WitsOCLab/Two-Inch-Photodetector/OPA818_TwoInch/BOM_OIP_OPA818.ods

One-Inch-Photodetector, OPA818
https://github.com/aewallin/One-Inch-Photodetector
REF | Description | part | footprint | QTY | price, EUR | total, EUR | Digikey/Farnell
 | MMCX-SMA lead |  |  | 1 | 9.55 | 9.55 | 744-1700-ND
D101,D103 | diode |  | SOD323F | 2 |  | 0
D102 | Photodiode |  | TO-18 | 1 |  | 0
J101 | MMCX conn | MMCX_Molex_73415-1471 |  | 1 | 2.39 | 2.39 | WM5557-ND
U104 | buffer | BUF602 | SOT23-5 | 1 | 2.1 | 2.1 | 296-19310-1-ND
U103 | opamp | OPA818IDRG | Wson-8 3x3 | 1 | 6.24 | 6.24 | 296-OPA818IDRGRCT-ND
U102 | vreg neg | LT3093 | MSOP-12 | 1 | 4.74 | 4.74 | LT3093EMSE#PBF-ND
U101 | vreg pos | LT3042 | MSOP-10 | 1 | 4.5 | 4.5 | LT3042EMSE#PBF-ND
 | Power supply | ±12 VDC 6 W, 100/120/230 VAC |  | 1 | 77.46 | 77.46 | Thorlabs LDS12B
 | M8 conn, lead | CBL FMALE TO WIRE LEAD 3P 4.92' |  | 1 | 6.91 | 6.91 | A120947-ND
 | Lumberg connector for power-supply | 3-pin female |  |  | SUM | 113.89
 |  |  |  |  |  |  |  | LUMBERG RSMV3 Male Connector
