WitsOCLab/Two-Inch-Photodetector/OPA818_TwoInch/oip_opa818.csv

Id | Designator | Footprint | Quantity | Designation | Supplier and ref
1 | D102 | TO-18-3 | 1 | S597x
2 | U101 | MSOP-10-1EP_3x3mm_P0.5mm_EP1.68x1.88mm | 1 | LT3042xMSE
3 | U102 | MSOP-12-1EP_3x4mm_P0.65mm_EP1.65x2.85mm | 1 | LT3093xMSE
4 | C101,C102,C103,C107,C112,C113,C114 | C_0603_1608Metric | 7 | 4u7
5 | C108,C105,C106,C109 | C_0603_1608Metric | 4 | 100n
6 | D103,D101 | D_SOD-323F | 2 | D
7 | J101,J1 | MMCX_Molex_73415-1471_Vertical | 2 | Conn_Coaxial
8 | L101 | L_0805_2012Metric | 1 | 100u
9 | R101,R107 | R_0603_1608Metric | 2 | 51k
10 | R102 | R_0603_1608Metric | 1 | 300R
11 | RF101 | R_0402_1005Metric | 1 | R
12 | R106 | R_0402_1005Metric | 1 | 49R9
13 | C115 | C_0402_1005Metric | 1 | C
14 | R1 | R_0402_1005Metric | 1 | 10R
15 | U103 | WSON-8-1EP_3x3mm_P0.5mm_EP1.45x2.4mm | 1 | OPA818IDRGx
16 | U104 | SOT-23-5 | 1 | BUF602xDBV
17 | C104 | C_0603_1608Metric | 1 | 10n
18 | R4 | R_0402_1005Metric | 1 | 100
19 | R3 | R_0402_1005Metric | 1 | 1.28k
20 | C6,C7 | NFM21C | 2 | NFM21PC105B1C3D
21 | C3 | C_0402_1005Metric | 1 | 10n
22 | R5 | R_0402_1005Metric | 1 | 49.9R
23 | RF1 | R_0402_1005Metric | 1 | 0R
24 | R2 | R_0402_1005Metric | 1 | 21.2k
25 | C5,C1 | C_0402_1005Metric | 2 | 100n
26 | C4 | C_0402_1005Metric | 1 | 1n
27 | U1 | MSOP-8_3x3mm_P0.65mm | 1 | AD8656
28 | R6 | R_0402_1005Metric | 1 | 470
29 | D1,D2 | LED_0201_0603Metric | 2 | LED
30 | TP101,TP102 | TestPoint_THTPad_D1.0mm_Drill0.5mm | 2 | TestPoint
31 | J102 | PinHeader_1x03_P2.54mm_Vertical | 1 | Conn_01x03
