WitsOCLab/Two-Inch-Photodetector/OPA818_TwoInch/oip_opa818.kicad_pcb

## KiCad design OPA818_TwoInch/oip_opa818.kicad_pcb (2025-04-06)

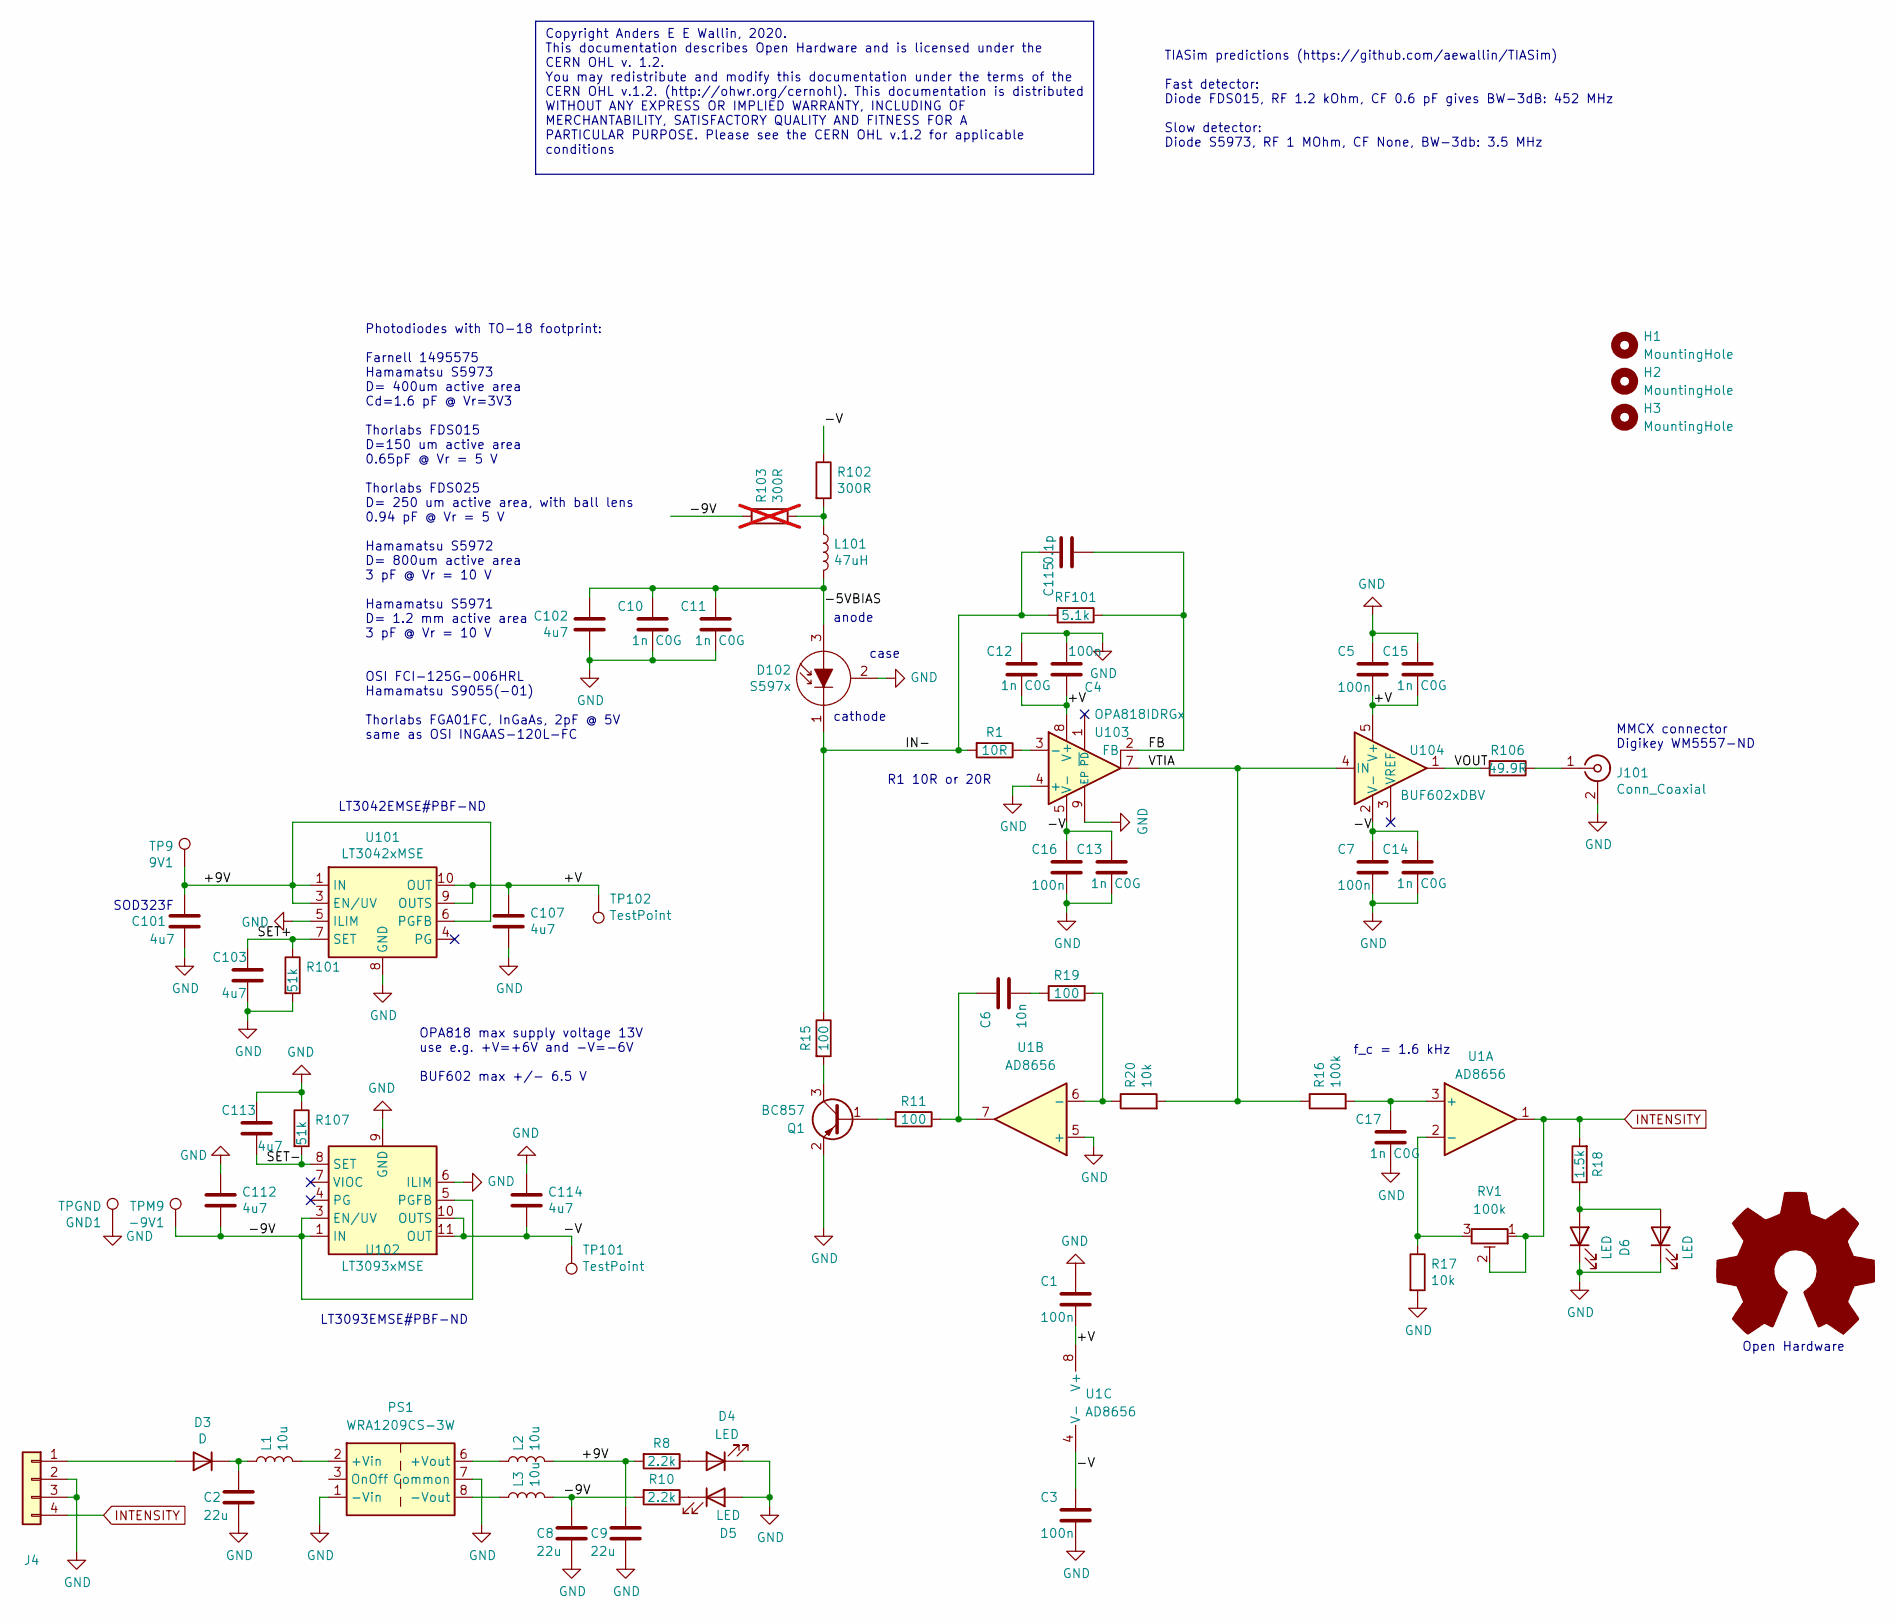
[picture p1: schematic oip_opa818.kicad_sch, 1" Photodiode Transimpedance Amplifier - OPA818 + BUF602]

Parts:
9V1: TP9; TestPoint_THTPad_D1.0mm_Drill0.5mm
-9V1: TPM9; TestPoint_THTPad_D1.0mm_Drill0.5mm
C1, C3, C4, C5, C7, C16: 100n; C_0402_1005Metric; JLCPCB C307331
C2, C8, C9: 22u; C_0805_2012Metric; JLCPCB C45783
C6: 10n; C_0402_1005Metric; LCSC C15195
C10, C11, C12, C13, C14, C15, C17: 1n C0G; C_0402_1005Metric; JLCPCB C76947
C101, C102, C103, C107, C112, C113, C114: 4u7; C_0603_1608Metric; JLCPCB C19666
C115: 0.1p; C_0402_1005Metric; LCSC C53273
D3: D; D_SOD-323F; JLCPCB C191023
D4, D5, D6, D7: LED; LED_0603_1608Metric; JLCPCB C72043
D102: S597x; TO-18-3
GND1: TPGND; TestPoint_THTPad_D1.0mm_Drill0.5mm
H1, H2, H3: MountingHole; MountingHole_3.2mm_M3_DIN965_Pad_TopBottom
J4: PinHeader_1x04_P2.54mm_Vertical
J101: Conn_Coaxial; MMCX_Molex_73415-1471_Vertical; JLCPCB C530664
L1, L2, L3: 10u; L_0805_2012Metric; JLCPCB C281113
L101: 47uH; L_0805_2012Metric; LCSC C404762
PS1: WRA1209CS-3W; Converter_DCDC_XP_POWER-ITQxxxxS-H_THT; LCSC C512079
Q1: BC857; SOT-323_SC-70; LCSC C8660
R1: 10R; R_0402_1005Metric; JLCPCB C25077
R8, R10: 2.2k; R_0402_1005Metric; JLCPCB C25879
R11, R15, R19: 100; R_0402_1005Metric; JLCPCB C25076
R16: 100k; R_0402_1005Metric; LCSC C25741
R17, R20: 10k; R_0402_1005Metric; LCSC C25744
R18: 1.5k; R_0603_1608Metric; LCSC C22843
R101, R107: 51k; R_0603_1608Metric; JLCPCB C23186
R102: 300R; R_0603_1608Metric; JLCPCB C23025
R103: 300R; R_0603_1608Metric; JLCPCB C23025; not fitted
R106: 49.9R; R_0402_1005Metric; JLCPCB C25120
RF101: 5.1k; R_0402_1005Metric; JLCPCB C351692
RV1: 100k; Potentiometer_Bourns_TC33X_Vertical; LCSC C719186
TP101, TP102: TestPoint; TestPoint_THTPad_D1.0mm_Drill0.5mm
U1: AD8656; MSOP-8_3x3mm_P0.65mm; LCSC C208582
U101: LT3042xMSE; MSOP-10-1EP_3x3mm_P0.5mm_EP1.68x1.88mm; LCSC C69847
U102: LT3093xMSE; MSOP-12-1EP_3x4mm_P0.65mm_EP1.65x2.85mm; LCSC C670490
U103: OPA818IDRGx; WSON-8-1EP_3x3mm_P0.5mm_EP1.45x2.4mm; JLCPCB C2859543
U104: BUF602xDBV; SOT-23-5; LCSC C2862949

Connections:
/+9V: 9V1.1, C9.1, C101.1, L2.2, R8.2, U101.1 (IN), U101.2 (IN), U101.3 (EN/UV), U101.6 (PGFB)
/+V: C1.2, C4.1, C5.2, C12.2, C15.2, C107.1, TP102.1, U1.8 (V+), U101.9 (OUTS), U101.10 (OUT), U103.8 (V+), U104.5 (V+)
/-5VBIAS: C10.1, C11.1, C102.1, D102.3 (A), L101.2
/-9V: -9V1.1, C8.1, C112.2, L3.2, R10.2, R103.1, U102.1 (IN), U102.2 (IN), U102.3 (EN/UV), U102.5 (PGFB), U102.13 (IN)
/-V: C3.1, C7.1, C13.1, C14.1, C16.1, C114.2, R102.1, TP101.1, U1.4 (V-), U102.10 (OUTS), U102.11 (OUT), U102.12 (OUT), U103.5 (V-), U104.2 (V-)
/FB: C115.1, RF101.1, U103.2 (FB)
/IN-: C115.2, D102.1 (K), R1.2, R15.1, RF101.2
/SET+: C103.1, R101.1, U101.7 (SET)
/SET-: C113.2, R107.2, U102.8 (SET)
/VOUT: R106.2, U104.1
/VTIA: R16.1, R20.2, U103.7, U104.4 (IN)
GND: C1.1, C2.2, C3.2, C4.2, C5.1, C7.2, C8.2, C9.2, C10.2, C11.2, C12.1, C13.2, C14.2, C15.1, C16.2, C17.2, C101.2, C102.2, C103.2, C107.2, C112.1, C113.1, C114.1, D4.1 (K), D5.2 (A), D6.1 (K), D7.1 (K), D102.2 (C), GND1.1, J4.2, J4.3, J101.2 (Ext), PS1.1 (-Vin), PS1.7 (Common), Q1.2 (E), R17.2, R101.2, R107.1, U1.5 (+), U101.5 (ILIM), U101.8 (GND), U101.11 (GND), U102.6 (ILIM), U102.9 (GND), U103.4 (+), U103.9 (EP)
INTENSITY: J4.4, R18.2, RV1.1, RV1.2, U1.1
unnamed: C6.1, R11.1, U1.7
unnamed: C6.2, R19.1
unnamed: D3.2 (A), J4.1
unnamed: C2.1, D3.1 (K), L1.1
unnamed: D4.2 (A), R8.1
unnamed: D5.1 (K), R10.1
unnamed: D6.2 (A), D7.2 (A), R18.1
unnamed: J101.1 (In), R106.1
unnamed: L101.1, R102.2, R103.2
unnamed: L1.2, PS1.2 (+Vin)
unnamed: L2.1, PS1.6 (+Vout)
unnamed: L3.1, PS1.8 (-Vout)
unnamed: Q1.1 (B), R11.2
unnamed: Q1.3 (C), R15.2
unnamed: C17.1, R16.2, U1.3 (+)
unnamed: R17.1, RV1.3, U1.2 (-)
unnamed: R19.2, R20.1, U1.6 (-)
unnamed: R1.1, U103.3 (-)

Notes on the sheet:
LT3042EMSE#PBF-ND
TIASim predictions (https://github.com/aewallin/TIASim) Fast detector: Diode FDS015, RF 1.2 kOhm, CF 0.6 pF gives BW-3dB: 452 MHz Slow detector: Diode S5973, RF 1 MOhm, CF None, BW-3db: 3.5 MHz
cathode
MMCX connector Digikey WM5557-ND
case
R1 10R or 20R
Open Hardware
Photodiodes with TO-18 footprint: Farnell 1495575 Hamamatsu S5973 D= 400um active area Cd=1.6 pF @ Vr=3V3 Thorlabs FDS015 D=150 um active area 0.65pF @ Vr = 5 V Thorlabs FDS025 D= 250 um active area, with ball lens 0.94 pF @ Vr = 5 V Hamamatsu S5972 D= 800um active area 3 pF @ Vr = 10 V Hamamatsu S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
OPA818 max supply voltage 13V use e.g. +V=+6V and -V=-6V BUF602 max +/- 6.5 V
Copyright Anders E E Wallin, 2020. This documentation describes Open Hardware and is licensed under the CERN OHL v. 1.2. You may redistribute and modify this documentation under the terms of the CERN OHL v.1.2. (http://ohwr.org/cernohl). This documentation is distributed WITHOUT ANY EXPRESS OR IMPL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
f_c = 1.6 kHz
anode
LT3093EMSE#PBF-ND
SOD323F

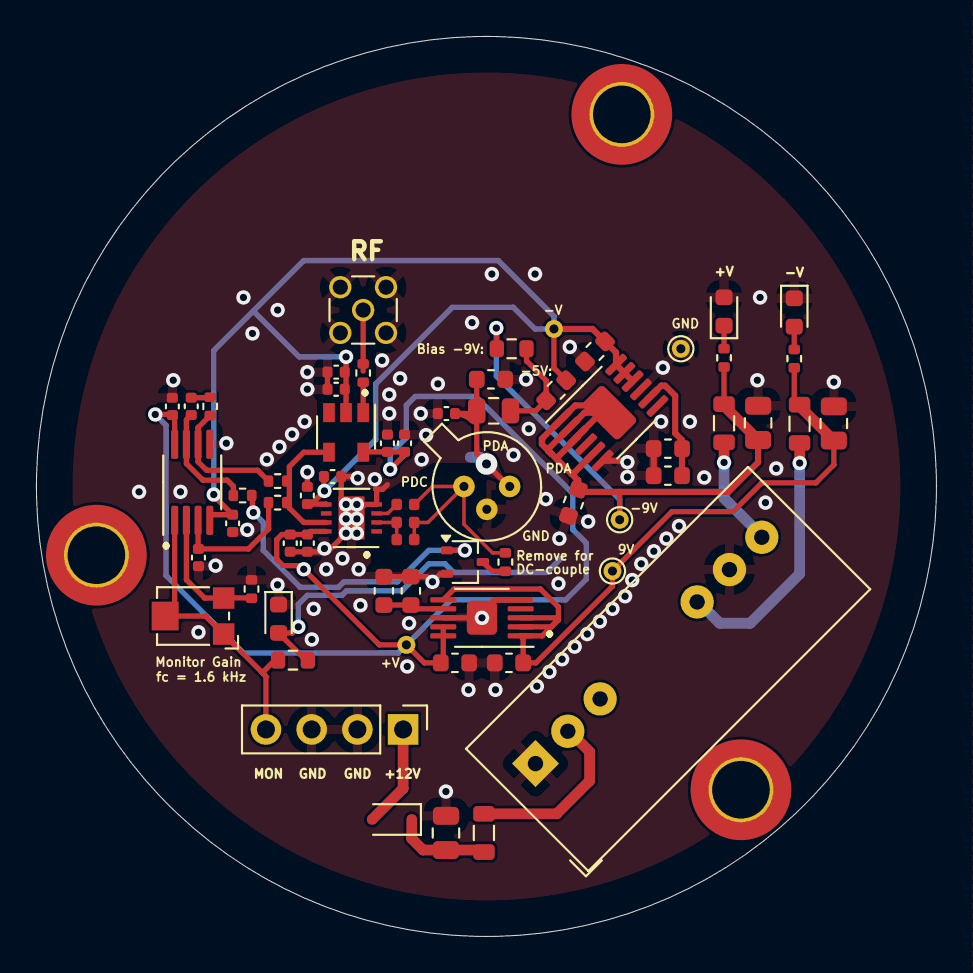
[picture p2: board oip_opa818.kicad_pcb from above]

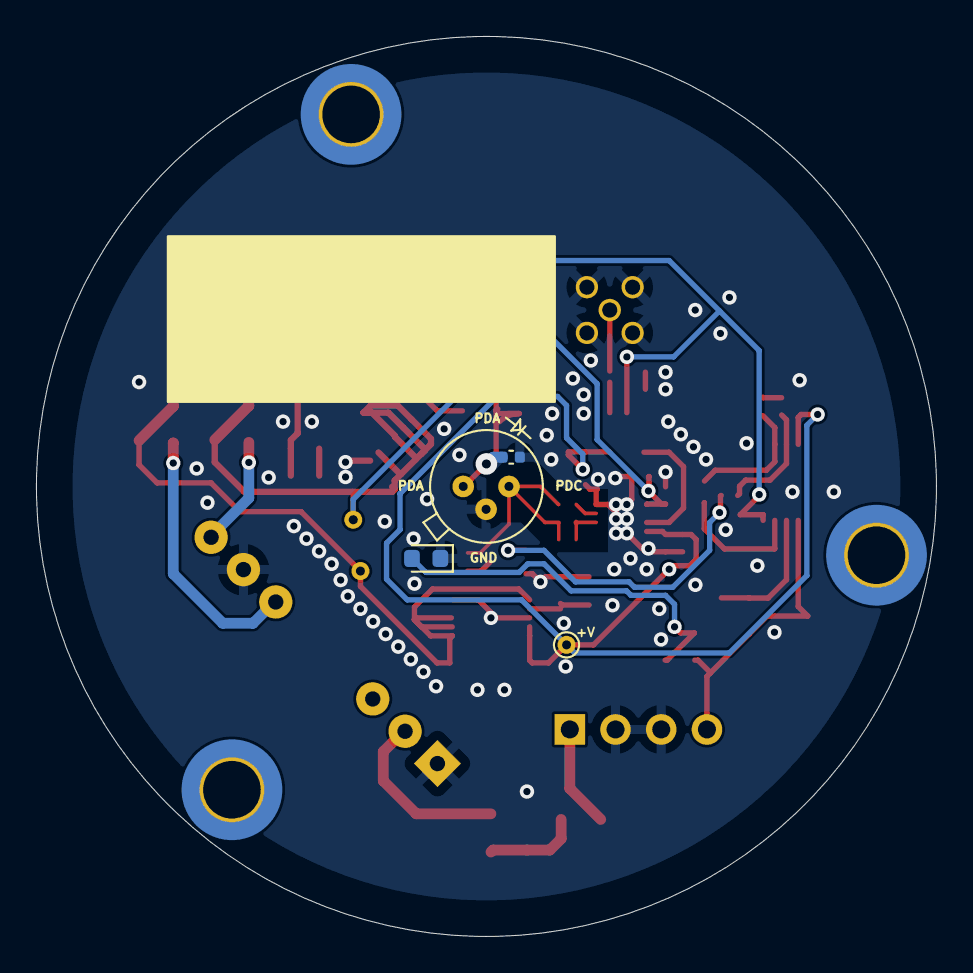
[picture p3: board oip_opa818.kicad_pcb from below]

Board: 2 copper layers, 50.0 x 50.0 mm, 69 parts (4 on the bottom side), 31 nets.
