WitsOCLab/Two-Inch-Photodetector/AD8015/OneInchAD8015/OneInchAD8015.kicad_pcb

## KiCad design AD8015/OneInchAD8015/OneInchAD8015.kicad_pcb (2025-03-28)

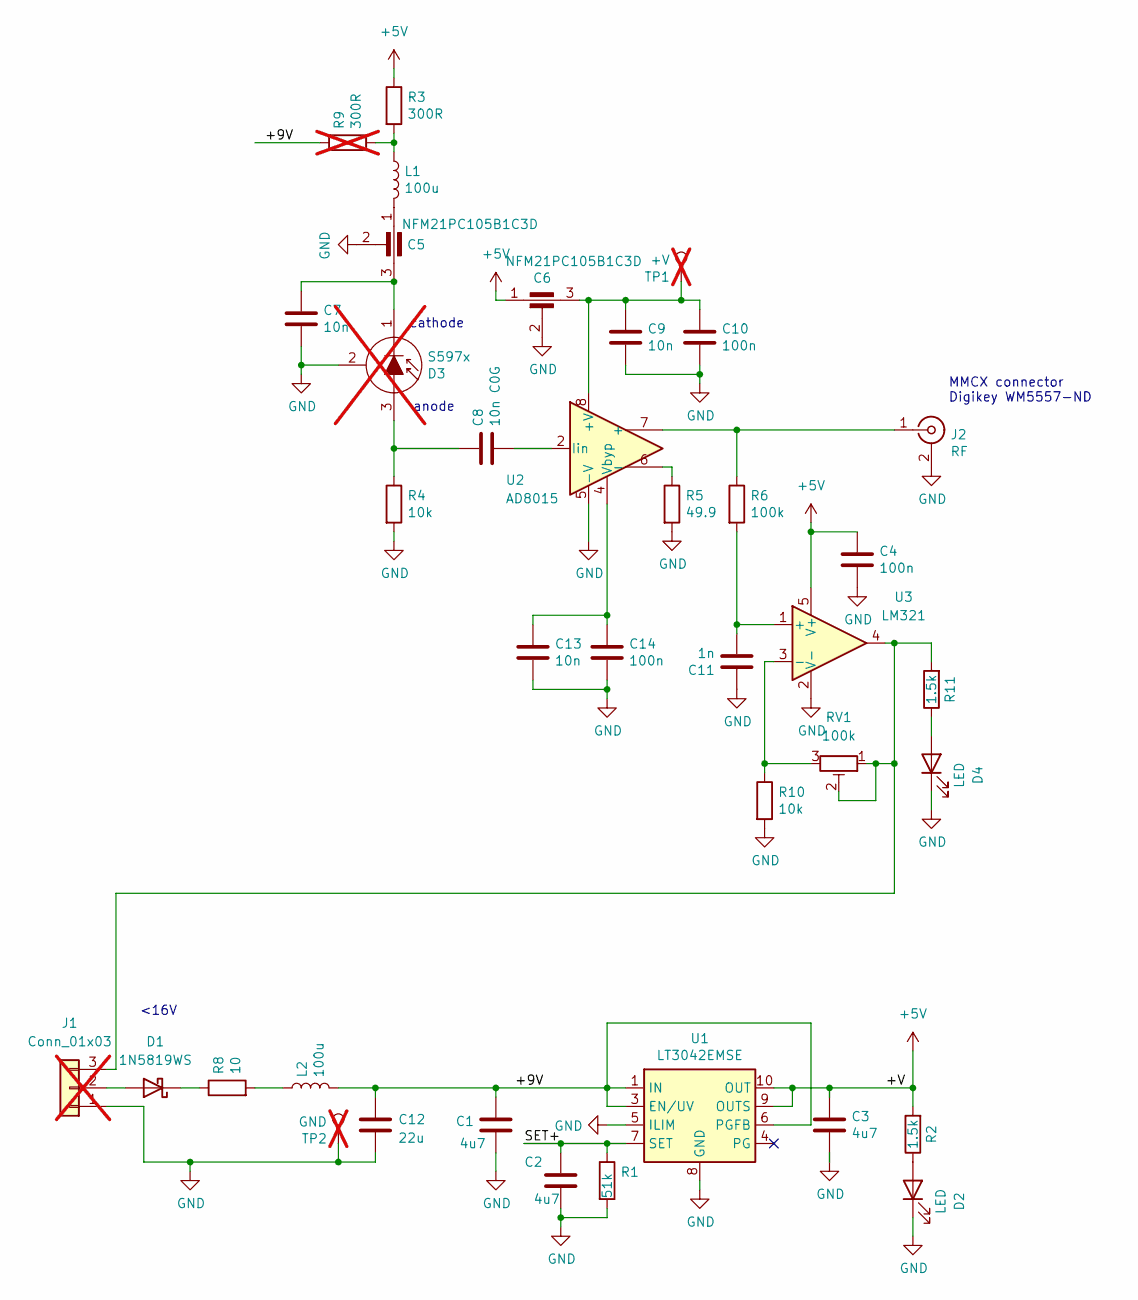
[picture p4: schematic OneInchAD8015.kicad_sch]

Parts:
C1, C2, C3: 4u7; C_0603_1608Metric; JLCPCB C19666
C4, C10, C14: 100n; C_0402_1005Metric; JLCPCB C1525
C5, C6: NFM21PC105B1C3D; NFM21C; LCSC C92518
C7, C9, C13: 10n; C_0402_1005Metric; JLCPCB C15195
C8: 10n C0G; C_0603_1608Metric; JLCPCB C76710
C11: 1n; C_0402_1005Metric; LCSC C1523
C12: 22u; C_0805_2012Metric; JLCPCB C45783
D1: 1N5819WS; D_SOD-323; LCSC C191023
D2, D4: LED; LED_0603_1608Metric; JLCPCB C72043
D3: S597x; TO-18-3; not fitted
J1: Conn_01x03; PinHeader_1x03_P2.00mm_Vertical; not fitted
J2: RF; MMCX_Molex_73415-1471_Vertical; JLCPCB C530664
L1, L2: 100u; L_0805_2012Metric; JLCPCB C68035
R1: 51k; R_0603_1608Metric; JLCPCB C23186
R2: 1.5k; R_0603_1608Metric; JLCPCB C25879
R3: 300R; R_0603_1608Metric; JLCPCB C23025
R4, R10: 10k; R_0402_1005Metric; LCSC C25744
R5: 49.9; R_0402_1005Metric; LCSC C325388
R6: 100k; R_0402_1005Metric; LCSC C25741
R8: 10; R_0603_1608Metric; JLCPCB C22859
R9: 300R; R_0603_1608Metric; not fitted
R11: 1.5k; R_0603_1608Metric; JLCPCB C21190
RV1: 100k; Potentiometer_Bourns_TC33X_Vertical; LCSC C719186
TP1: +V; TestPoint_THTPad_D1.0mm_Drill0.5mm; not fitted
TP2: GND; TestPoint_THTPad_D1.0mm_Drill0.5mm; not fitted
U1: LT3042EMSE; MSOP-10-1EP_3x3mm_P0.5mm_EP1.68x1.88mm; LCSC C69847
U2: AD8015; SOIC-8_3.9x4.9mm_P1.27mm; LCSC C514255
U3: LM321; SOT-23-5; LCSC C471859

Connections:
+5V: C3.1, C4.1, C6.1, R2.2, R3.1, U1.9 (OUTS), U1.10 (OUT), U3.5 (V+)
/+9V: C1.1, C12.1, L2.2, R9.1, U1.1 (IN), U1.2 (IN), U1.3 (EN/UV), U1.6 (PGFB)
/SET+: C2.1, R1.1, U1.7 (SET)
GND: C1.2, C2.2, C3.2, C4.2, C5.2, C6.2, C7.2, C9.2, C10.2, C11.1, C12.2, C13.2, C14.2, D2.1 (K), D3.2 (C), D4.1 (K), J1.1, J2.2 (Ext), R1.2, R4.2, R5.2, R10.2, TP2.1, U1.5 (ILIM), U1.8 (GND), U1.11 (GND), U2.5 (-V), U3.2 (V-); also elsewhere on the board
unnamed: C5.1, L1.2
unnamed: D1.2 (A), J1.2
unnamed: D1.1 (K), R8.1
unnamed: D2.2 (A), R2.1
unnamed: C8.1, D3.3 (A), R4.1
unnamed: C5.3, C7.1, D3.1 (K)
unnamed 10: D4.2 (A), R11.1; also elsewhere on the board
unnamed: J1.3, R11.2, RV1.1, RV1.2, U3.4
unnamed: J2.1 (In), R6.1, U2.7 (+)
unnamed: L1.1, R3.2, R9.2
unnamed: L2.1, R8.2
unnamed: C6.3, C9.1, C10.1, TP1.1, U2.8 (+V)
unnamed: R5.1, U2.6 (-)
unnamed: C8.2, U2.2 (Iin)
unnamed: C13.1, C14.1, U2.4 (Vbyp)
unnamed: C11.2, R6.2, U3.1 (+)
unnamed: R10.1, RV1.3, U3.3 (-)

Notes on the sheet:
<16V
anode
MMCX connector Digikey WM5557-ND
cathode

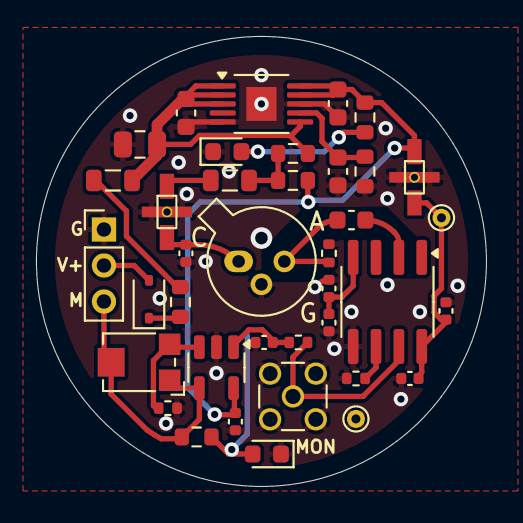
[picture p5: board OneInchAD8015.kicad_pcb from above]

Board: 2 copper layers, 25.0 x 25.0 mm, 39 parts (1 on the bottom side), 21 nets.

Other parts of the board:
D5: LED; LED_0603_1608Metric

Their connections:
GND: D5.1 (K); also elsewhere on the board
unnamed 10: D5.2 (A); also elsewhere on the board
