WitsOCLab/Two-Inch-Photodetector/(commit log)

2023-05-30 2 inch version
    [BOM_OIP_OPA818.ods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]
2023-12-30 v1 for jlc
    [bom.csv, designators.csv, oip_opa818.csv, oip_opa818.kicad_pcb, oip_opa818.kicad_sch, positions.csv]
2025-01-06 v1 of OneInchAD8015
    [APD-TIA.kicad_pcb, APD-TIA.kicad_sch, OneInchAD8015.kicad_pcb, OneInchAD8015.kicad_sch, bom.csv, designators.csv, oip_opa818.kicad_pcb, oip_opa818.kicad_sch]
2025-01-13 pot for mon
    [OneInchAD8015.kicad_pcb, OneInchAD8015.kicad_sch, bom.csv, designators.csv, positions.csv]
2025-04-06 seems to be done, ac coupled
    [bom.csv, designators.csv, oip_opa818.kicad_pcb, oip_opa818.kicad_sch, positions.csv]
